apparentlymart/avr-pgm-board/avrboard.kicad_pcb

## KiCad design avrboard.kicad_pcb (2014-04-21)

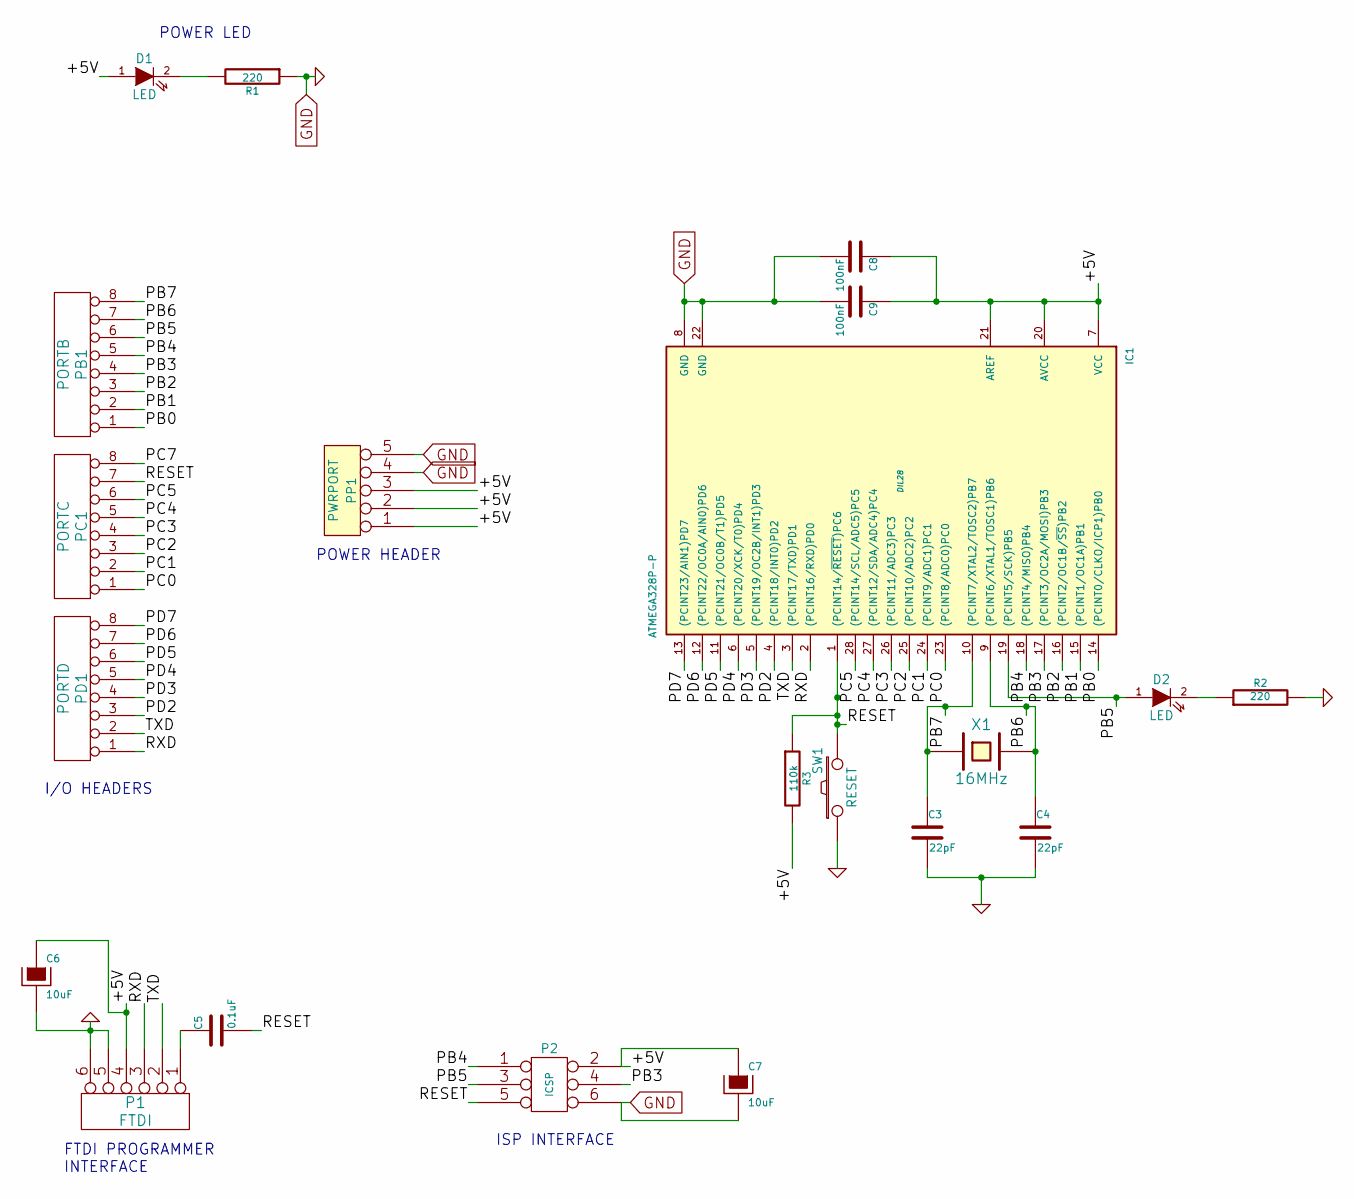
[picture p1: schematic avrboard.sch, AVR Development Board]

Parts:
C3, C4: 22pF
C5: 0.1uF
C6, C7: 10uF
C8, C9: 100nF
D1, D2: LED
IC1: ATMEGA328P-P; DIL28
P1: FTDI
P2: ICSP
PB1: PORTB
PC1: PORTC
PD1: PORTD
PP1: PWRPORT
R1, R2: 220
R3: 110k
SW1: RESET
X1: 16MHz

Connections:
/+5V: C6.1, C7.1, C8.1, C9.1, D1.1 (A), IC1.7 (VCC), IC1.20 (AVCC), IC1.21 (AREF), P1.4, P2.2, PP1.1, PP1.2, PP1.3, R3.2
/PB0: IC1.14 ((PCINT0/CLKO/ICP1)PB0), PB1.1
/PB1: IC1.15 ((PCINT1/OC1A)PB1), PB1.2
/PB2: IC1.16 ((PCINT2/OC1B/~SS~)PB2), PB1.3
/PB3: IC1.17 ((PCINT3/OC2A/MOSI)PB3), P2.4, PB1.4
/PB4: IC1.18 ((PCINT4/MISO)PB4), P2.1, PB1.5
/PB5: D2.1 (A), IC1.19 ((PCINT5/SCK)PB5), P2.3, PB1.6
/PB6: C4.1, IC1.9 ((PCINT6/XTAL1/TOSC1)PB6), PB1.7, X1.2
/PB7: C3.1, IC1.10 ((PCINT7/XTAL2/TOSC2)PB7), PB1.8, X1.1
/PC0: IC1.23 ((PCINT8/ADC0)PC0), PC1.1
/PC1: IC1.24 ((PCINT9/ADC1)PC1), PC1.2
/PC2: IC1.25 ((PCINT10/ADC2)PC2), PC1.3
/PC3: IC1.26 ((PCINT11/ADC3)PC3), PC1.4
/PC4: IC1.27 ((PCINT12/SDA/ADC4)PC4), PC1.5
/PC5: IC1.28 ((PCINT14/SCL/ADC5)PC5), PC1.6
/PC7: PC1.8
/PD2: IC1.4 ((PCINT18/INT0)PD2), PD1.3
/PD3: IC1.5 ((PCINT19/OC2B/INT1)PD3), PD1.4
/PD4: IC1.6 ((PCINT20/XCK/T0)PD4), PD1.5
/PD5: IC1.11 ((PCINT21/OC0B/T1)PD5), PD1.6
/PD6: IC1.12 ((PCINT22/OC0A/AIN0)PD6), PD1.7
/PD7: IC1.13 ((PCINT23/AIN1)PD7), PD1.8
/RESET: C5.2, IC1.1 ((PCINT14/~RESET~)PC6), P2.5, PC1.7, R3.1, SW1.2
/RXD: IC1.2 ((PCINT16/RXD)PD0), P1.3, PD1.1
/TXD: IC1.3 ((PCINT17/TXD)PD1), P1.2, PD1.2
GND: C3.2, C4.2, C6.2, C7.2, C8.2, C9.2, IC1.8 (GND), IC1.22 (GND), P1.5, P1.6, P2.6, PP1.4, PP1.5, R1.1, R2.2, SW1.1
unnamed: C5.1, P1.1
unnamed: D1.2 (K), R1.2
unnamed: D2.2 (K), R2.1

Notes on the sheet:
POWER LED
FTDI PROGRAMMER INTERFACE
I/O HEADERS
POWER HEADER
ISP INTERFACE

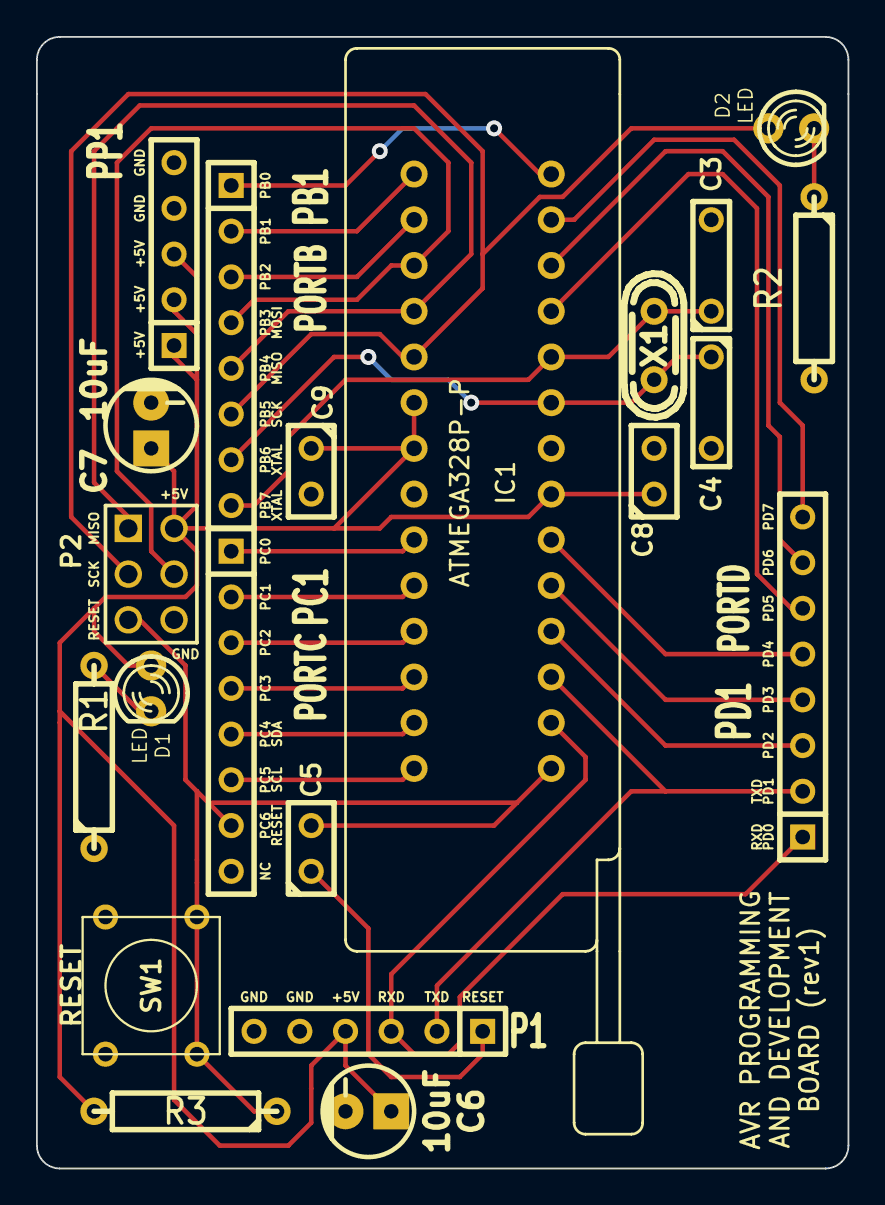
[picture p2: board avrboard.kicad_pcb from above]

Board: 2 copper layers, 45.1 x 62.9 mm, 21 parts (0 on the bottom side), 28 nets.
