apparentlymart/avr-pgm-board/(commit log)

2014-04-20 Initial Import
    [avrboard.kicad_pcb, avrboard.sch]
2014-04-20 Route to the the RESET pin via the back of the board.
    This allows the RESET signal to hope over the serial TX/RX signals.
    [avrboard.kicad_pcb]
2014-04-20 Unhide the back copper layer.
    [avrboard.kicad_pcb]
2014-04-20 Finish routing the PCB traces.
    Got a little ugly towards the end to get the traces to the programming
    headers, but not too bad. Might revise later.
    [avrboard.kicad_pcb]
2014-04-20 Connect AREF to +5V.
    No sensible way to route AREF, so for now the compromise is to just route
    it to +5V so the ADC can be *usable* when configured to use an external
    voltage source (e.g. for testing after programming) while not being
    particularly accurate (since this is going to be noisy.)
    Given that the primary purpose of this board is programming and then
    post-programming brief testing, with the chip ultimately ending up in
    a dedicated PCB design, this seems like a reasonable compromise.
    [avrboard.kicad_pcb, avrboard.sch]
2014-04-20 Remove the power regulator from the design.
    Since this board is primarily for programming, it's fine to just get
    power from the ICSP or FTDI headers in most cases, which should already
    be regulated to 5V.
    There was nowhere in the design for the power barrel jack to go anyway,
    so this saves a little more space and also allows the ICSP header to move
    closer to the SPI pins and thus fix some of the more awkward routes
    from the previous iteration.
    [avrboard.kicad_pcb, avrboard.sch]
2014-04-20 More port labels and some track routing adjustments.
    [avrboard.kicad_pcb]
2014-04-20 Move the PORTB headers to the other side of the chip.
    The routing is less crazy this way, since many of the port B pins are on
    that side, and the power and port B headers can both fit together on that
    side.
    [avrboard.kicad_pcb]
2014-04-20 Clean up the silkscreen and remove some "bays" from the ground plane.
    [avrboard.kicad_pcb]
2014-04-21 Move the FTDI socket over to increase clearance from the ZIF lever.
    [avrboard.kicad_pcb]
2014-04-21 Add board outline.
    [avrboard.kicad_pcb]
2014-04-21 Correct the size of the ZIF socket.
    The footprint was 75mil too short.
    [avrboard.kicad_pcb]
2014-04-21 Remove one of the fill keepouts to repair the ground plane.
    [avrboard.kicad_pcb]
2014-04-21 Prepare plotter settings for Gerber export.
    [avrboard.kicad_pcb]
2014-04-21 Further silkscreen layout tweaking.
    Some captions were overlapping. Now none are overlapping.
    [avrboard.kicad_pcb]
2014-04-21 Include a caption on the back silkscreen.
    OSH Park refuses to accept an empty back silkscreen layer, for some
    reason.
    [avrboard.kicad_pcb]
2014-04-21 Remove a redundant "GND" label from an earlier version.
    [avrboard.kicad_pcb]
2014-04-21 Update plotter settings for OSH Park manufacturing.
    [avrboard.kicad_pcb]
